T3610/Pipe-Crawling-Robot/PCB/PCB.kicad_pcb

## KiCad design PCB/PCB.kicad_pcb (2026-11-05)

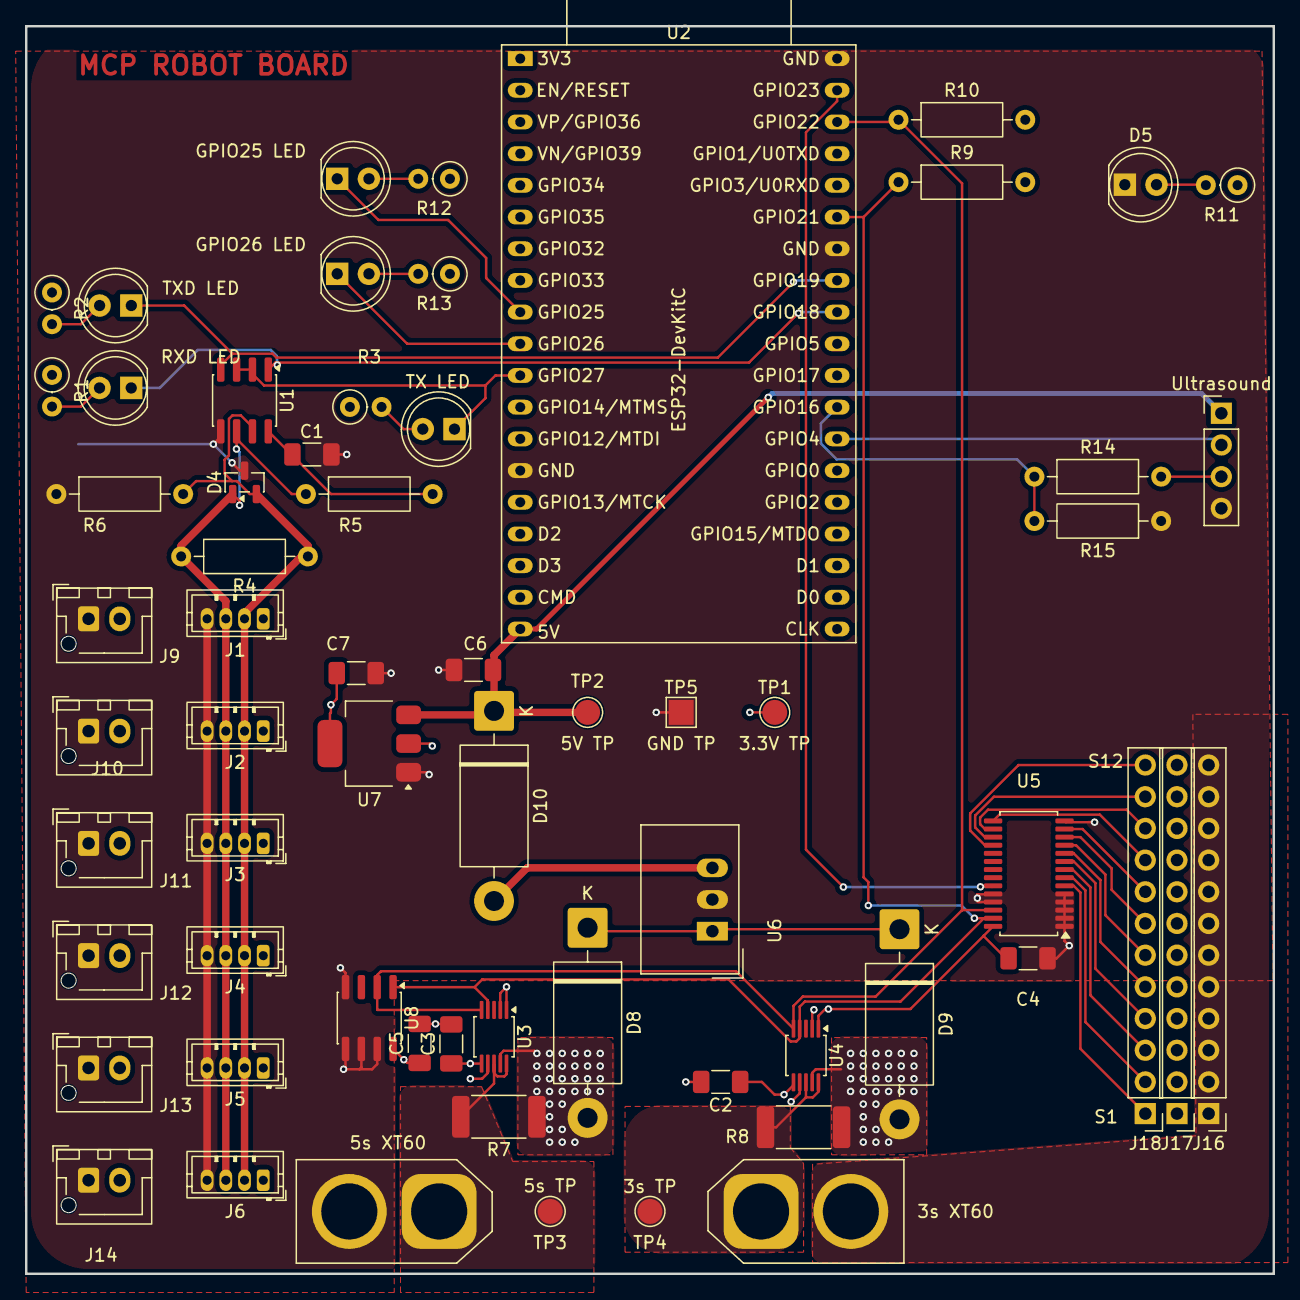
[picture p1: board PCB.kicad_pcb from above]

Board: 4 copper layers, 100.0 x 100.0 mm, 63 parts (0 on the bottom side), 40 nets.

Parts:
3s XT60, 5s XT60: Conn_01x02; AMASS_XT60-M_1x02_P7.20mm_Vertical
C1, C2, C3, C4, C5: 100n; C_1206_3216Metric_Pad1.33x1.80mm_HandSolder
C6, C7: 10u; C_1206_3216Metric_Pad1.33x1.80mm_HandSolder
D4: SM712_SOT23; SOT-23
D5: LED; LED_D5.0mm
D8, D9, D10: 1N5822; D_DO-201AD_P15.24mm_Horizontal
GPIO25 LED, GPIO26 LED: LED; LED_D5.0mm
J1, J2, J3, J4, J5, J6: Conn_01x04; JST_ZH_B4B-ZR_1x04_P1.50mm_Vertical
J9, J10, J11, J12, J13, J14: Conn_01x02; JST_XH_B2B-XH-AM_1x02_P2.50mm_Vertical
J16, J17, J18: Conn_01x12; PinHeader_1x12_P2.54mm_Vertical
R1, R2, R3: 1000; R_Axial_DIN0207_L6.3mm_D2.5mm_P2.54mm_Vertical
R4: 120; R_Axial_DIN0207_L6.3mm_D2.5mm_P10.16mm_Horizontal
R5, R6, R9, R10: 4k7; R_Axial_DIN0207_L6.3mm_D2.5mm_P10.16mm_Horizontal
R7, R8: 2m; R_2512_6332Metric_Pad1.40x3.35mm_HandSolder
R11, R12, R13: 300; R_Axial_DIN0207_L6.3mm_D2.5mm_P2.54mm_Vertical
R14: 1000; R_Axial_DIN0207_L6.3mm_D2.5mm_P10.16mm_Horizontal
R15: 2200; R_Axial_DIN0207_L6.3mm_D2.5mm_P10.16mm_Horizontal
RXD LED: LED; LED_D5.0mm
TP1: 3.3V TP; TestPoint_Pad_D2.0mm
TP2: 5V TP; TestPoint_Pad_D2.0mm
TP3: 5s TP; TestPoint_Pad_D2.0mm
TP4: 3s TP; TestPoint_Pad_D2.0mm
TP5: GND TP; TestPoint_Pad_2.0x2.0mm
TX LED: LED; LED_D5.0mm
TXD LED: LED; LED_D5.0mm
U1: MAX3485; SOIC-8_3.9x4.9mm_P1.27mm
U2: ESP32-DevKitC
U3, U4: INA226; TSSOP-10_3x3mm_P0.5mm
U5: PCA9685PW; TSSOP-28_4.4x9.7mm_P0.65mm
U6: TSR_1-2450; Converter_DCDC_TRACO_TSR-1_THT
U7: AMS1117-3.3; SOT-223-3_TabPin2
U8: LM75B; SOIC-8_3.9x4.9mm_P1.27mm
Ultrasound: Conn_01x04; PinHeader_1x04_P2.54mm_Vertical

Connections:
+3V3: C1.1, C2.1, C3.1, C4.1, C5.1, C7.1, R1.1, R2.1, R3.1, R5.2, R9.2, R10.2, R11.1, R12.1, R13.1, TP1.1 (1_1), U1.8 (VCC), U3.1 (A1), U3.2 (A0), U3.6 (VS), U4.1 (A1), U4.6 (VS), U5.28 (VDD), U7.2 (VO), U8.8 (+Vs)
+3s_LIPO: D9.2 (A), J17.1, J17.2, J17.3, J17.4, J17.5, J17.6, J17.7, J17.8, J17.9, J17.10, J17.11, J17.12, R8.1, U4.9 (Vin-)
+3s_LIPO_EXT: 3s XT60.1, R8.2, TP4.1 (1_1), U4.8 (Vbus), U4.10 (Vin+)
+5V: C6.1, D10.1 (K), TP2.1 (1_1), U2.19 (5V), U7.3 (VI), Ultrasound.1
+5s_LIPO: D8.2 (A), J9.2, J10.2, J11.2, J12.2, J13.2, J14.2, R7.1, U3.9 (Vin-)
+5s_LIPO_EXT: 5s XT60.1, R7.2, TP3.1 (1_1), U3.8 (Vbus), U3.10 (Vin+)
/485_N: D4.2 (A2), J1.2, J2.2, J3.2, J4.2, J5.2, J6.2, R4.1, R6.2, U1.7 (B)
/485_P: D4.1 (A1), J1.3, J2.3, J3.3, J4.3, J5.3, J6.3, R4.2, R5.1, U1.6 (A)
/RXD_485: RXD LED.1 (K), U1.1 (RO), U2.30 (GPIO18)
/SCL: R10.1, U2.36 (GPIO22), U3.5 (SCL), U4.5 (SCL), U5.26 (SCL), U8.2 (SCL)
/SDA: R9.1, U2.33 (GPIO21), U3.4 (SDA), U4.4 (SDA), U5.27 (SDA), U8.1 (SDA)
/SERVO_1: J18.1, U5.6 (LED0)
/SERVO_2: J18.2, U5.7 (LED1)
/SERVO_3: J18.3, U5.8 (LED2)
/SERVO_4: J18.4, U5.9 (LED3)
/SERVO_5: J18.5, U5.10 (LED4)
/SERVO_6: J18.6, U5.11 (LED5)
/SERVO_7: J18.7, U5.12 (LED6)
/SERVO_8: J18.8, U5.13 (LED7)
/SERVO_9: J18.9, U5.15 (LED8)
/SERVO_10: J18.10, U5.16 (LED9)
/SERVO_11: J18.11, U5.17 (LED10)
/SERVO_12: J18.12, U5.18 (LED11)
/SERVO_EN: U2.37 (GPIO23), U5.23 (~OE)
/STAT_LED_1: GPIO25 LED.1 (K), U2.9 (DAC_1/ADC2_CH8/GPIO25)
/STAT_LED_2: GPIO26 LED.1 (K), U2.10 (DAC_2/ADC2_CH9/GPIO26)
/TXD_485: TXD LED.1 (K), U1.4 (DI), U2.31 (GPIO19)
/TX_485_EN: TX LED.1 (K), U1.2 (~RE), U1.3 (DE), U2.11 (ADC2_CH7/GPIO27)
/US_ECHO: R14.1, R15.2, U2.27 (GPIO16)
/US_TRIG: U2.26 (ADC2_CH0/GPIO4), Ultrasound.2
GND: 3s XT60.2, 5s XT60.2, C1.2, C2.2, C3.2, C4.2, C5.2, C6.2, C7.2, D4.3 (common), D5.1 (K), J1.4, J2.4, J3.4, J4.4, J5.4, J6.4, J9.1, J10.1, J11.1, J12.1, J13.1, J14.1, J16.1, J16.2, J16.3, J16.4, J16.5, J16.6, J16.7, J16.8, J16.9, J16.10, J16.11, J16.12, R6.1, R15.1, TP5.1 (1_1), U1.5 (GND), U2.14 (GND), U2.32 (GND), U2.38 (GND), U3.7 (GND), U4.2 (A0), U4.7 (GND), U5.1 (A0), U5.2 (A1), U5.3 (A2), U5.4 (A3), U5.5 (A4), U5.14 (VSS), U5.24 (A5), U5.25 (EXTCLK), U6.2 (GND), U7.1 (GND), U8.4 (GND), U8.5 (A2), U8.6 (A1), U8.7 (A0), Ultrasound.4
unnamed: R1.2, RXD LED.2 (A)
unnamed: R2.2, TXD LED.2 (A)
unnamed: R3.2, TX LED.2 (A)
unnamed: D5.2 (A), R11.2
unnamed: GPIO25 LED.2 (A), R12.2
unnamed: GPIO26 LED.2 (A), R13.2
unnamed: D8.1 (K), D9.1 (K), U6.1 (Vin)
unnamed: D10.2 (A), U6.3 (Vout)
unnamed: R14.2, Ultrasound.3
