T3610/Pipe-Crawling-Robot/(commit log)

2026-11-02 PCB half done
    [PCB-B_Cu.gbr, PCB-B_Mask.gbr, PCB-B_Paste.gbr, PCB-B_Silkscreen.gbr, PCB-Edge_Cuts.gbr, PCB-F_Cu.gbr, PCB-F_Mask.gbr, PCB-F_Paste.gbr]
2026-11-02 Updated PCB
    [PCB-B_Cu.gbl, PCB-B_Mask.gbs, PCB-B_Paste.gbp, PCB-B_Silkscreen.gbo, PCB-Edge_Cuts.gm1, PCB-F_Cu.gtl, PCB-F_Mask.gts, PCB-F_Paste.gtp]
2026-11-04 finalised V1 PCB
    [PCB.kicad_pcb]
2026-11-05 finalised v2 PCB
    [PCB-B_Cu.gbl, PCB-B_Cu.gbr, PCB-B_Mask.gbr, PCB-B_Paste.gbr, PCB-B_Silkscreen.gbr, PCB-Edge_Cuts.gbr, PCB-F_Cu.gbr, PCB-F_Cu.gtl]
2026-11-05 updated but still not working
    [main.py]
